ESPboy-edu/ESPboy_WalkieTalkie/pics/LTK5128.png

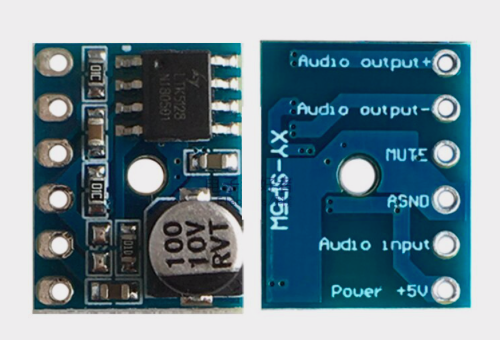
pics/LTK5128.png
