ESPboy-edu/ESPboy_WalkieTalkie/pics/MAX9814.png

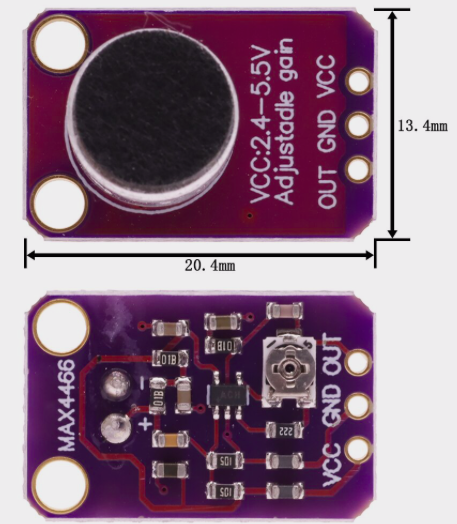
pics/MAX9814.png
