ESPboy-edu/ESPboy_WalkieTalkie/pics/SA868.png

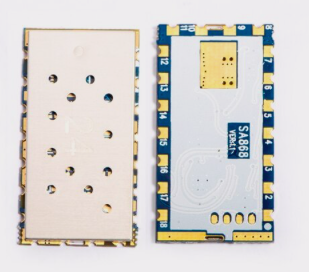
pics/SA868.png
